r315/laser4-plus/doc/laser4.jpg

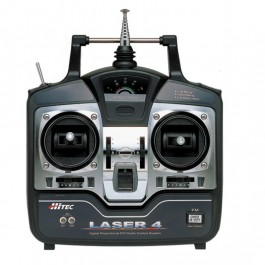
doc/laser4.jpg
