r315/laser4-plus/doc/Laser4+_revA_Schematic.PDF

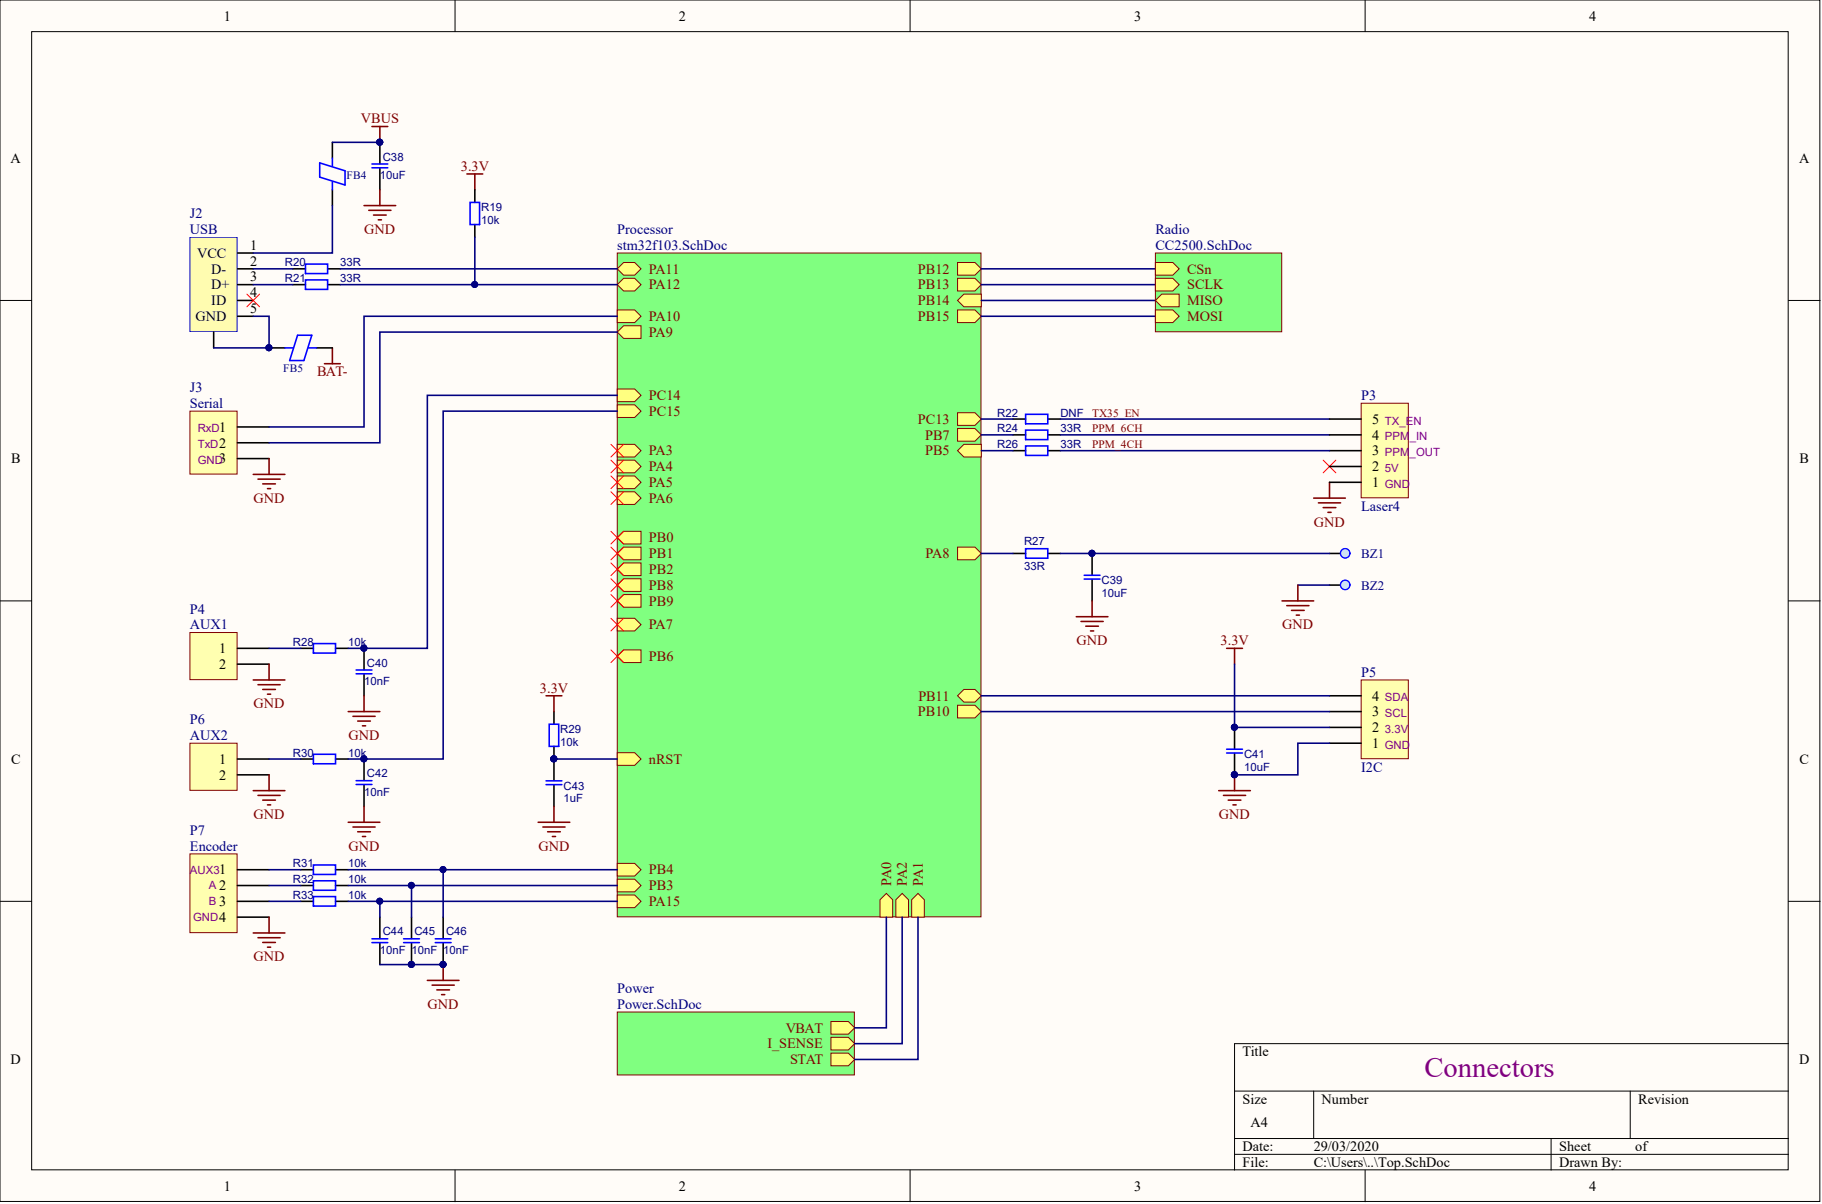
[picture p8: page 1]

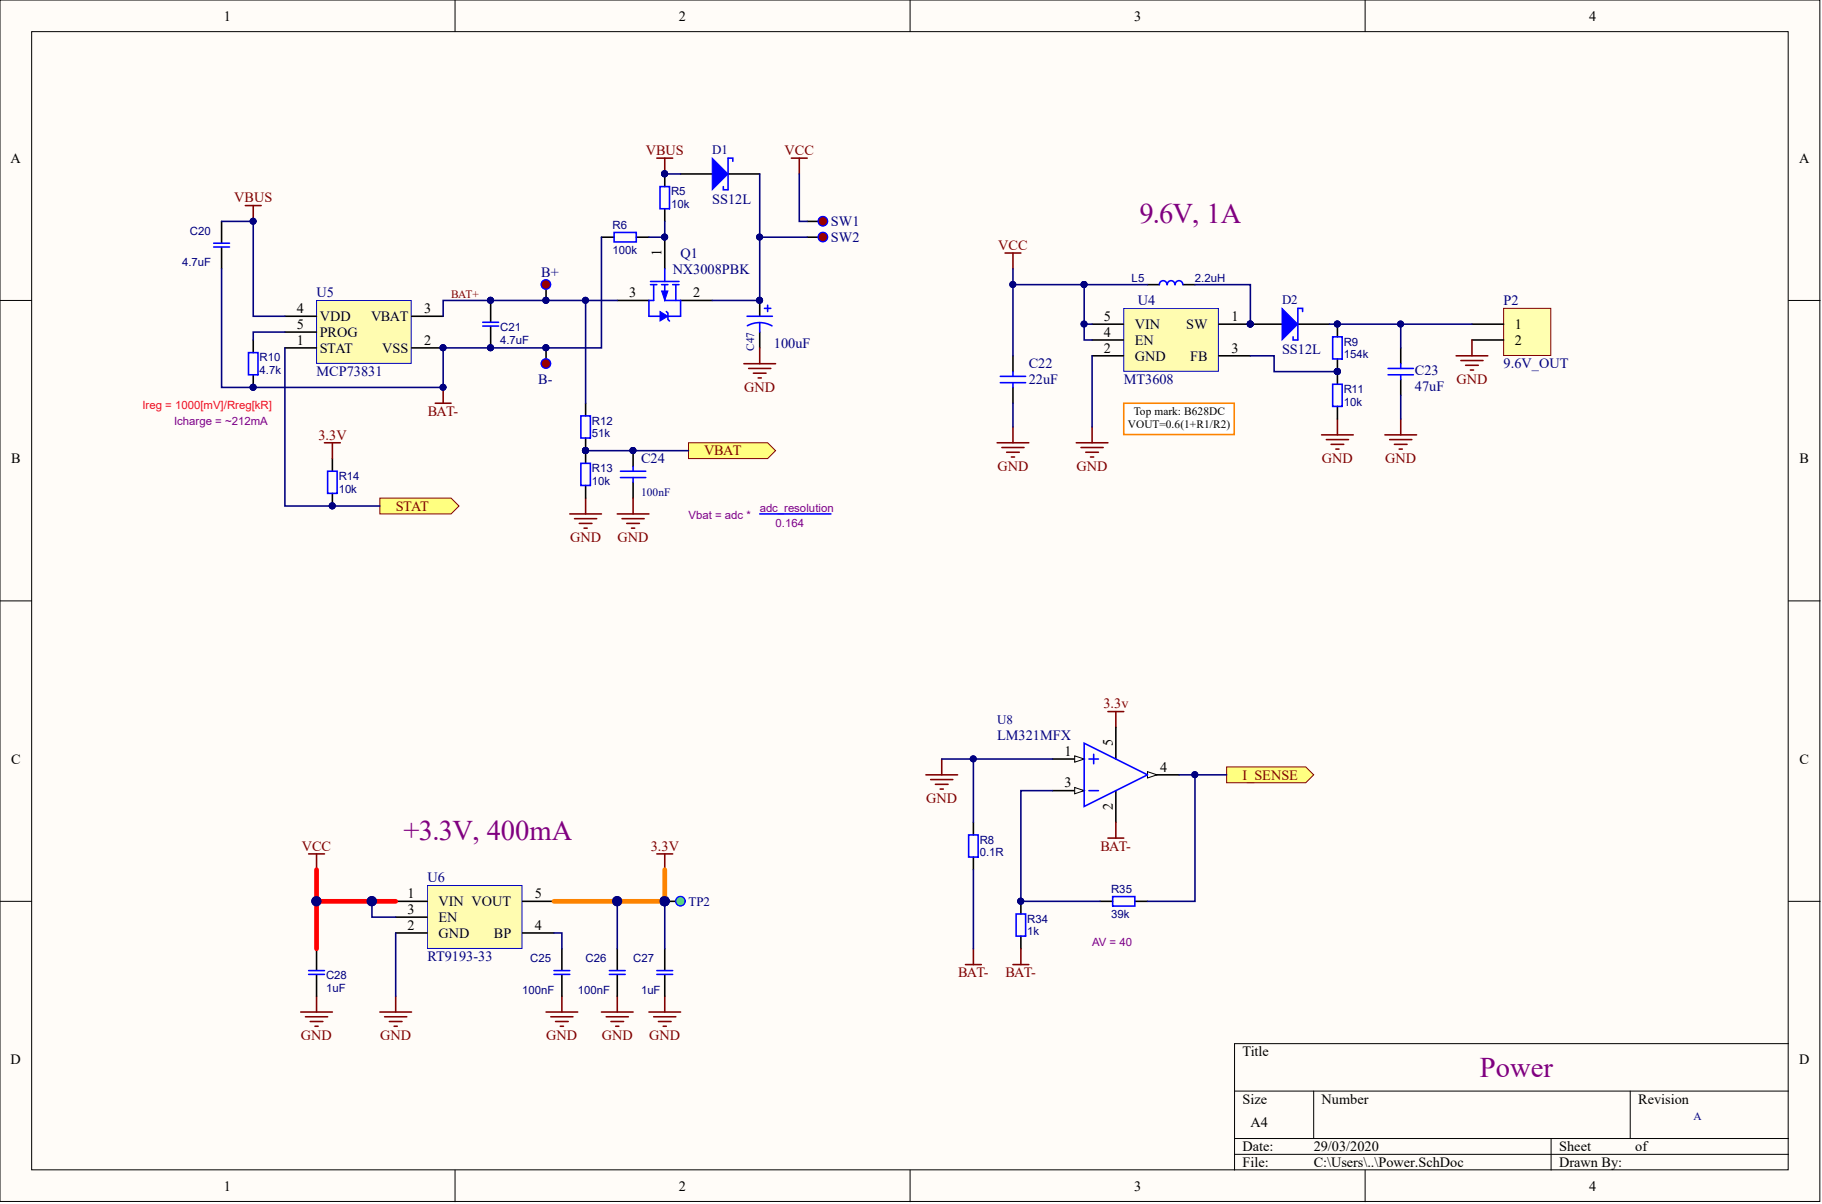
[picture p9: page 2]

Ireg = 1000[mV]/Rreg[kR]
Icharge = ~212mA

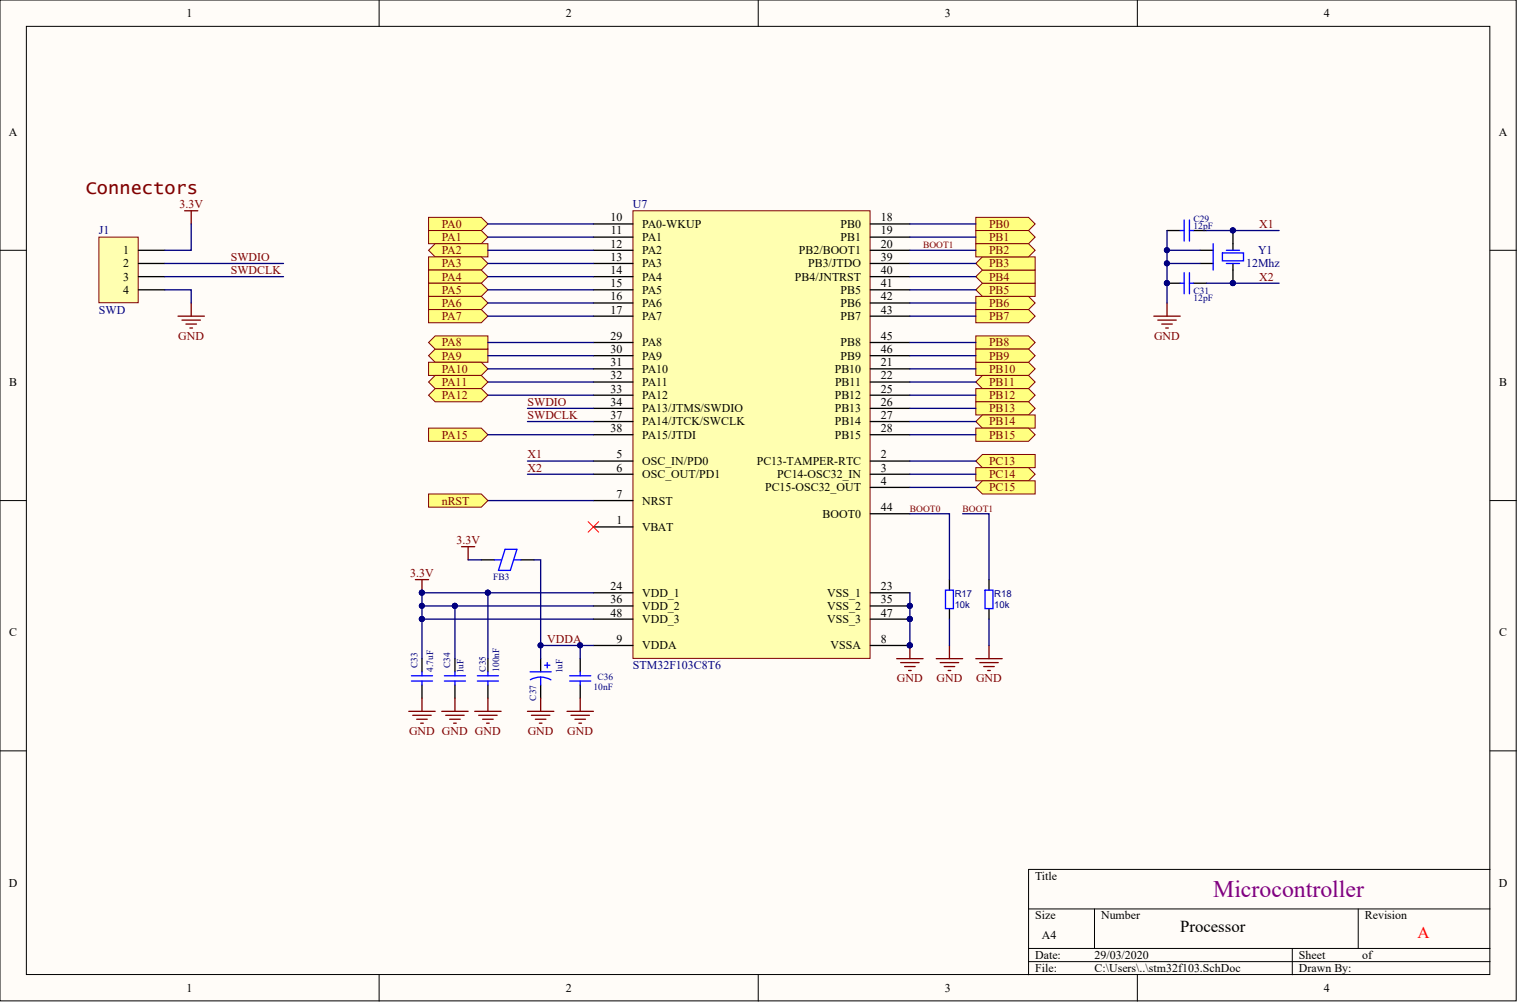
[picture p10: page 3]

VDD_2 36
VDD_3 48

VDDA 9 | | 8

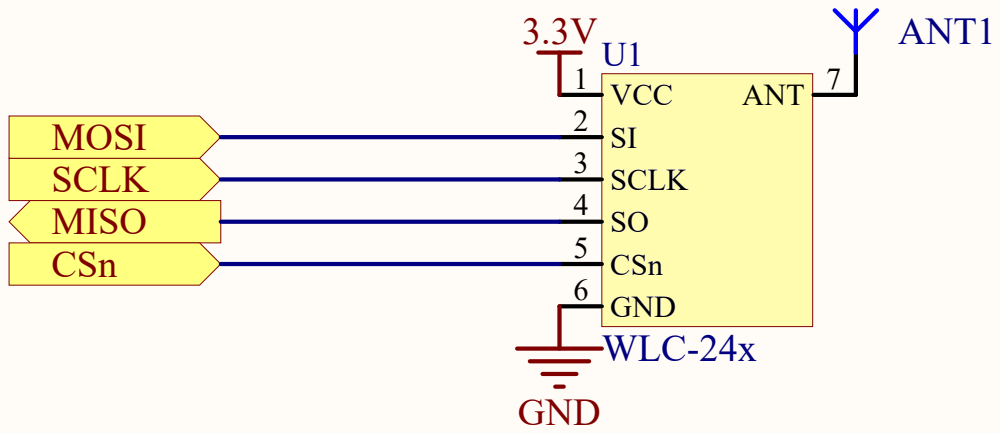
[picture p11: page 4]
