r315/laser4-plus/(commit log)

2019-12-14 Add spi driver
2019-12-21 Integrated cc2500 low level driver
2019-12-27 Added timers configurations and ram EEPROM
2020-01-04 Working stage
2020-01-04 moved setup and loop to laser4_plus.c with non-blobking calls
2020-01-04 Refactor timer name
2020-01-04 Add timer and watchdog api
2020-01-08 Add gpio interrupt support (only on PB5)
2020-01-09 REN: board.c -> laser4_plus_board.c
2020-01-09 REF: Board_Init->laser4Init
2020-01-10 REM: interrupt attach
2020-01-10 MOV: ppm code to board module
2020-01-11 Settle on pulse measure by pin interrupot
2020-01-12 Fix: flash page erase
    [board.h, laser4_plus_board.c]
2020-01-12 Fix: bind by command
    [commands.cpp]
2020-01-12 REM: unused function prototype
2020-01-19 implemented battery voltage reading and tx 35MHz enable
2020-01-19 move hw init to board file
2020-01-20 Optimized mode switch
2020-01-21 Implemented HW access to aux buttons
2020-01-22 HW implementation of rotary encoder
2020-01-24 Implemented AUX3 change with rotary encoder
2020-01-25 Renamed timers
2020-01-25 Update ppm_data with aux switches values
2020-01-25 Implemented PPM output on pin PB7
2020-01-28 CHG: AUX3 input pin
2020-01-28 Print battery voltage on startup
2020-01-28 Read encoder to aux2
2020-01-29 CHG: symbols for hardware switches
2020-01-29 revert mode for ppm
    [app.h, laser4_plus.cpp]
2020-01-31 print current remode mode
2020-01-31 print ppm data
2020-01-31 print cc2500 status
2020-02-14 Battery voltage and adc resolution
2020-02-15 moved usb interrupt handler
2020-02-15 Integarted usb composite device
2020-02-15 Add file for usb device, new api for resume/suspend callbacks
2020-02-19 add button test mode
2020-02-20 bodge for composit device
2020-02-23 Fix: message print on unloaded data
    [laser4_plus.cpp]
2020-02-23 MOV: Encoder variabl to radioo structure
2020-02-29 FIX: ppm timer issue
    [laser4_plus_board.c]
2020-02-29 IMP: Software timers, changed setPpmFlag function visibility
2020-02-29 ADD: Test case for simulating ppm signal from remote
2020-03-07 Improved adc logic and extend api
2020-03-07 Add missing eeprom data
    [laser4_plus.cpp]
2020-03-07 Implemented commands for adc and eeprom
2020-03-08 Current measurement api
2020-03-08 CHG: Convert multiple analog channels with DMA
    Added parameters to adc command for configure
    battery voltage divider
2020-03-08 Add missing eeprom access from application
    [laser4_plus.cpp]
2020-03-08 IMP: Sense resistor configuration
2020-03-10 REM: current information from status command
2020-03-12 Integrated i2c non blocking calls
2020-03-15 Extended battery voltage and current API
2020-03-15 Change bit mask for drawIcon and costum format string
    update overload for uint32_t values.
    Fix for return position for non-drawable character
    [mpanel.cpp, mpanel.h]
2020-03-15 Fix bug for ppm sim timer
    [commands.cpp]
2020-03-15 Optimize software timers
2020-03-15 Limit for current and voltage
2020-03-16 New symbols for battery
2020-03-17 Change build symbol for 12MHZ Split status command print Removed battery values clipping Antecipated default mode request to avoid overwriting previous requests
    [commands.cpp, laser4_plus.cpp, laser4_plus_board.c]
2020-03-20 IMP: Setting buzzer volume
    [app.h, board.h, commands.cpp, laser4_plus.cpp, laser4_plus_board.c]
2020-03-28 IMP: print sw version on startup, optimized startup mode request
    This also fixes short delay after startup tone and mode tone
    [commands.cpp, laser4_plus.cpp, mpanel.h]
2020-05-16 Added Icons for binding and errorAdded single variable for application flags.Single lcd update on application loop, avoid concurent updates.
    [app.h, board.h, commands.cpp, laser4_plus.cpp, laser4_plus_board.c]
2020-05-16 Disable debug pin, due to not having available pins.
2020-05-16 Update adc command help and makefile
    "make bootloader" now also programs the boot loader
2020-07-25 FIX: Pin configuration for CC2500 + PA
    [board.h]
2025-08-10 WIP: Migration, fix multiple buid errors
    [board.h, commands.cpp, laser4_plus.cpp, laser4_plus.h, laser4_plus_board.c, startup_stm32f103.c]
2025-08-11 FIX: debug output to uart
    [board.h, laser4_plus.cpp, laser4_plus.h, laser4_plus_board.c]
2025-08-13 ADD: Board selection macros
2025-08-17 CHG: buzzer to configurable fuature
    [commands.cpp, laser4_plus.cpp, laser4_plus_board.c]
2025-08-23 REM: Unused uart library
    This library was replaced by libemb
2025-08-24 MOV: main to board
    Not sure if good idea, but this way each board has it's own main function
2025-08-24 FIX: Dependency of laser4_plus header
    [app.h, commands.cpp, laser4_plus.cpp, laser4_plus.h]
2025-08-24 FIX: build errror when usb feature is disabled
    [game_controller.c]
2025-08-24 CHG: battery monitoring to feature
2025-08-24 CHG: Use dma api for battery monitoring
2025-08-24 CHG: buzzer to libemb tone
    [laser4_plus_board.c]
2025-08-25 ADD: Missing changes on
    - Migration of buzzer to libemb tone
    - Renamed symbol
    [board.h]
2025-08-25 CHG: PPM generator to use libemb dma api
2025-08-25 CHG: Extracted encoder functionality to board
2025-08-25 IMP: cpu id function CHG: aux switches as feature
2025-08-25 FIX: uart buffer overwrite issues
2025-08-26 MOV: board specific symbols to board application
2025-08-26 FIX: commands text alingment
    [commands.cpp]
2025-08-26 FIX: same ppm out pulse CHG: ppmout signature to support number of channels ADD: Comments
    [board.h, commands.cpp, laser4_plus_board.c]
2025-08-26 FIX: mode selection from command line
    [board.h, commands.cpp, laser4_plus.cpp, laser4_plus.h]
2025-08-27 REM: STM32_BOARD symbol and unnecessary interrups disable/enable
2025-08-27 CHG: Extracted base timer functionality to board
2025-08-27 FIX: display feature build errors
    [board.h, laser4_plus.cpp, laser4_plus_board.c, mpanel.cpp, mpanel.h]
2025-08-28 IMP: Error message if cc2500 is not detected and debug prints
2025-08-28 FIX: missing ppm flag check
    [commands.cpp]
2025-08-28 UPD: aux switches and encoder handling
2025-08-28 FIX: Calculation of servo default value
2025-08-29 CHG: Made game controller as protocol
    This way usb hid device is used as a protocol on multiprotocol
2025-08-29 FIX: missmatch mode on startup
    [laser4_plus.cpp]
2025-08-30 IMP: ppm sim configurable values
    This is the start of PWM output implementation
2025-09-02 FIX: random 4/6 channels on ppm output
    As ppm decode sometimes would update radio.nchannel
    between remote_callback and update_all, nchannel had wrong
    value on next callback.
    Now ppm decode only signals multiprotocol and then values/nchannels are fetched
    on the correct time.
    [commands.cpp]
2025-09-03 MOV: Unused PWM code
2025-09-04 FIX: bug on strformater
    [mpanel.cpp]
2025-09-04 UPD: Led/debug pin symbols
2025-09-06 FIX: release build for l4p
    [startup_stm32f103.c]
2025-09-07 FIX: missing display configuration data
    [board.h, laser4_plus_board.c]
2025-09-08 IMP: battery voltage and current on status command
2025-09-08 REV: removal on ppm_data array on ppm decode
    This array was wrongly replaced by pointer to radio.channel_data. These arrays cannot be the
    same, because radio.channel_data is always updated
    [commands.cpp]
2025-09-18 Drop dependency of hal cortex and spi
2025-09-18 WIP: droping hal dependency
    Moved lcd stuff from board to app
    Fix HAL header dependency
    [board.h, laser4_plus.cpp, laser4_plus_board.c]
2025-09-19 Refactor extracted usb device into static library
2025-09-21 CHG: separate i2c bus from display driver and initialize display from app
2025-09-21 FIX: hardfault if display fails to initialize ADD: API for uptime and current consumed
    [commands.cpp, laser4_plus.cpp, laser4_plus.h]
2025-09-22 FIX: Minor UI bugs
    [laser4_plus.cpp, laser4_plus_board.c, mpanel.h]
2025-09-22 REV: display pin com config
2025-09-22 FIX: hardfault when calling c++ constructors
    Somehow there was an missalignment when loading
    class members data that caused a hardfault with -Os.
    Reordering members solved the issue
    [mpanel.cpp, mpanel.h]
2025-09-26 FIX: Build warning, missign characters
    [mpanel.cpp]
2025-09-26 CHG: Enable dma for i2c
2025-10-01 FIX: "Late callback problem"
    Updating any information on display takes more time.
    This fix ensures that display updates only occur when there is time.
    [board.h, commands.cpp, laser4_plus.cpp, laser4_plus.h, laser4_plus_board.c]
2025-10-02 FIX: USB connection startup behavior
    [laser4_plus.cpp]
2025-10-02 FIX: Non operational encoder on laser4 board Submodule updated
    [board.h]
2025-10-03 CHG: default servo values according board
2025-10-03 CHG: FrSky channel conversion formula
    This seams to better suit standard servo values
2025-10-03 IMP: Configurable servo range values for each channel
2025-10-04 IMP: servo range configuration through cli
2025-10-04 REV: Removal of channel initialization.
    Without this initialization, encoder channel value
    remains zero until encoder is moved
2025-10-04 IMP: Print channel ppm and servo data on status command
2025-10-04 IMP: Servo limits
2025-10-05 MOV: pcom variable to app ADD: missing ifdef
    [laser4_plus.cpp, laser4_plus_board.c]
2025-10-05 CHG: Replaced swtimer by stimer
    [board.h, commands.cpp, laser4_plus.cpp, laser4_plus_board.c]
2025-10-06 CHG: Replaced watchdog by libemb
    [board.h, laser4_plus.cpp, laser4_plus_board.c]
2025-10-08 Port for dk415 board without usb
